analogman2/Jim-o-Lantern/cad/out/preview_body.png

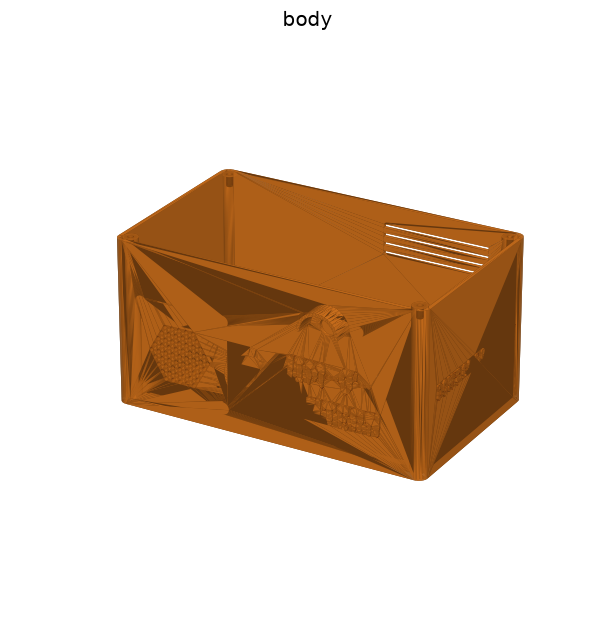
cad/out/preview_body.png
