analogman2/Jim-o-Lantern/cad/out/preview_body_inside.png

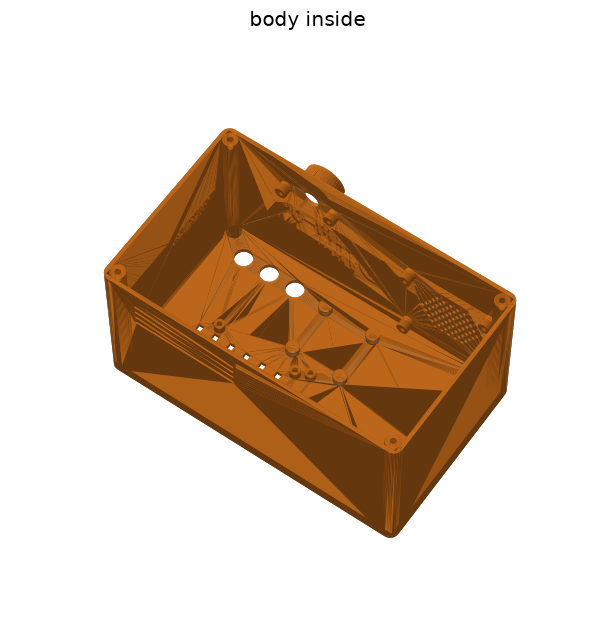
cad/out/preview_body_inside.png
