analogman2/Jim-o-Lantern/cad/out/preview_camera_mount.png

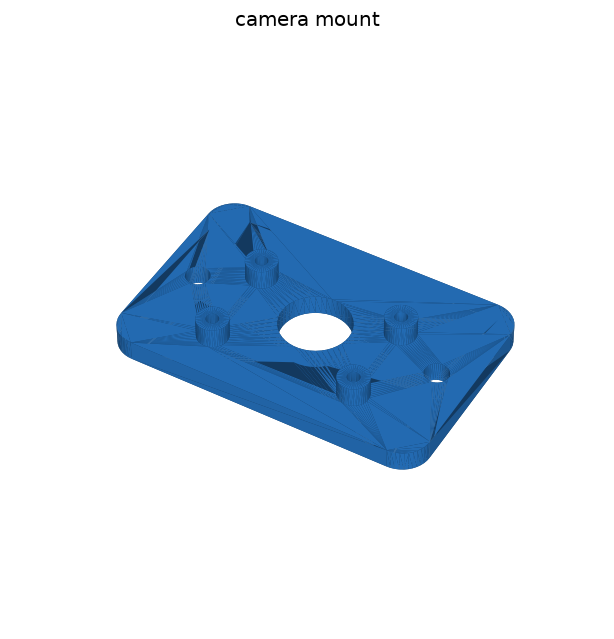
cad/out/preview_camera_mount.png
