analogman2/Jim-o-Lantern/cad/out/preview_lid.png

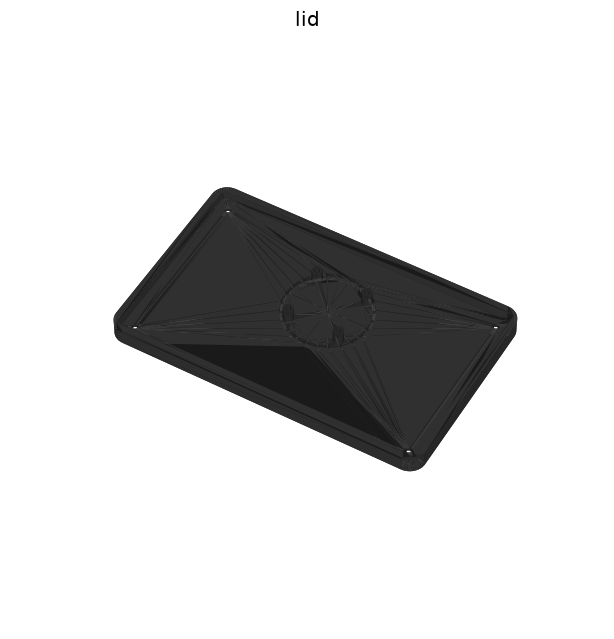
cad/out/preview_lid.png
