analogman2/Jim-o-Lantern/cad/out/preview_post_socket.png

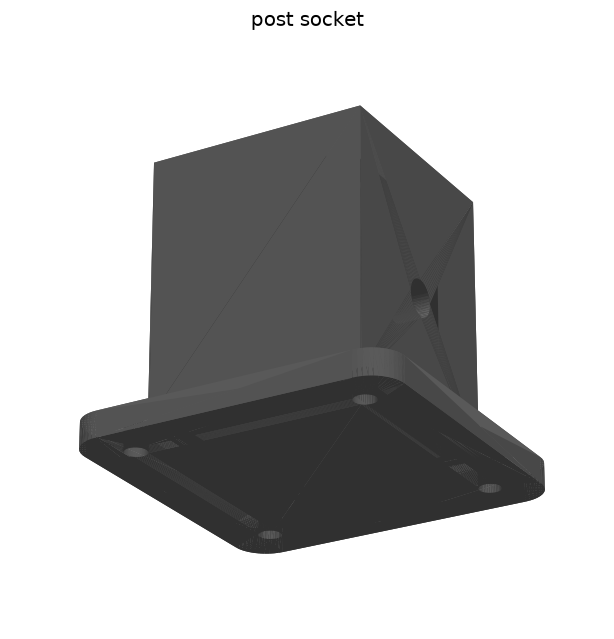
cad/out/preview_post_socket.png
