analogman2/Jim-o-Lantern/cad/out/preview_speaker_cup.png

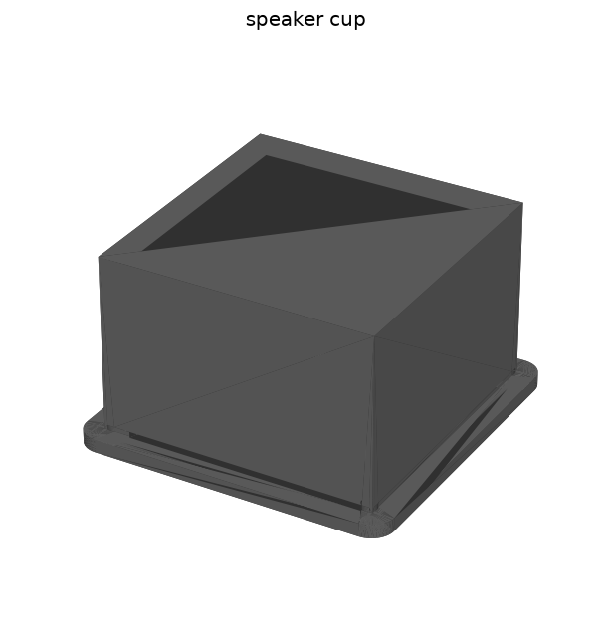
cad/out/preview_speaker_cup.png
