analogman2/Jim-o-Lantern/cad/out/lid.step

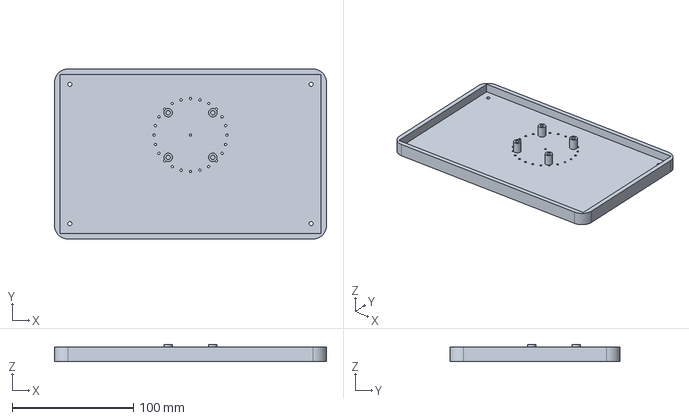
[picture p9: CAD file, 2026-10-14]
cad/out/lid.step
224.0 x 140.0 x 14.0 mm
