analogman2/Jim-o-Lantern/cad/out/camera_mount.step

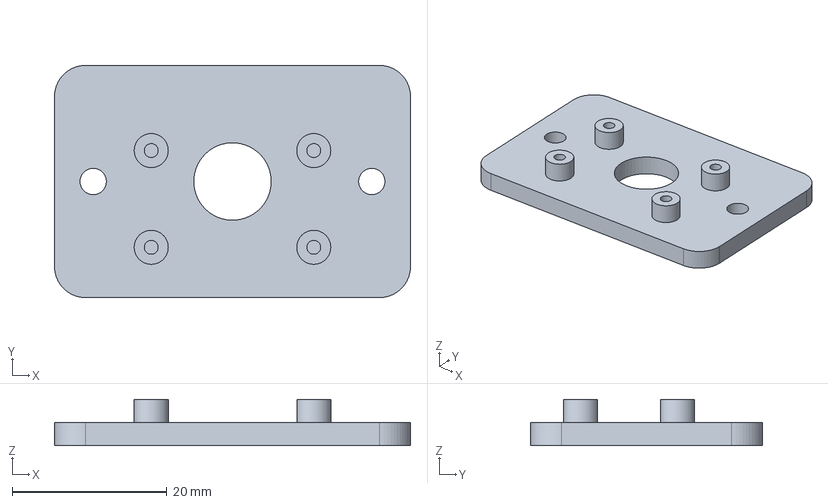
[picture p10: CAD file, 2026-10-14]
cad/out/camera_mount.step
46.0 x 30.0 x 6.00 mm
