analogman2/Jim-o-Lantern/cad/out/post_socket.step

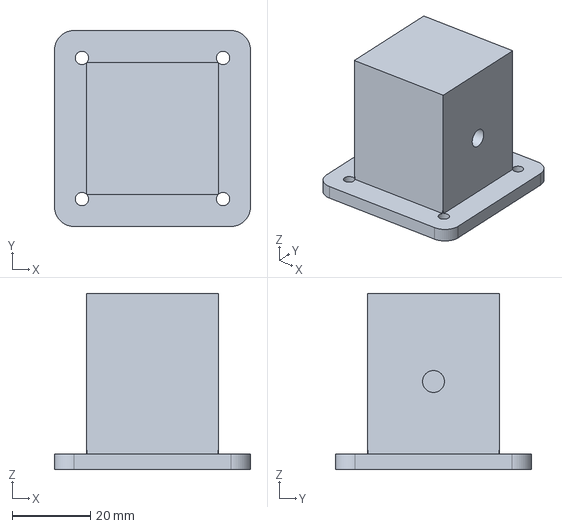
[picture p11: CAD file, 2026-10-14]
cad/out/post_socket.step
50.0 x 50.0 x 45.0 mm
