analogman2/Jim-o-Lantern/cad/out/logo.step

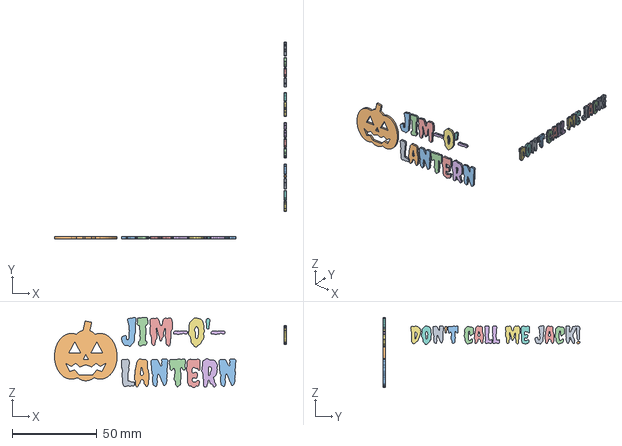
[picture p12: CAD file, 2026-10-14]
cad/out/logo.step
136.6 x 116.1 x 41.4 mm
