analogman2/Jim-o-Lantern/cad/out/speaker_cup.step

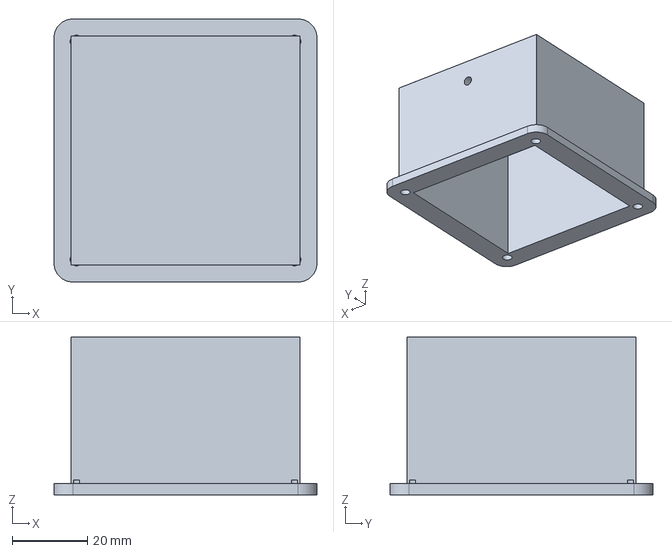
[picture p13: CAD file, 2026-10-14]
cad/out/speaker_cup.step
70.0 x 70.0 x 42.0 mm
