analogman2/Jim-o-Lantern/cad/out/body.step

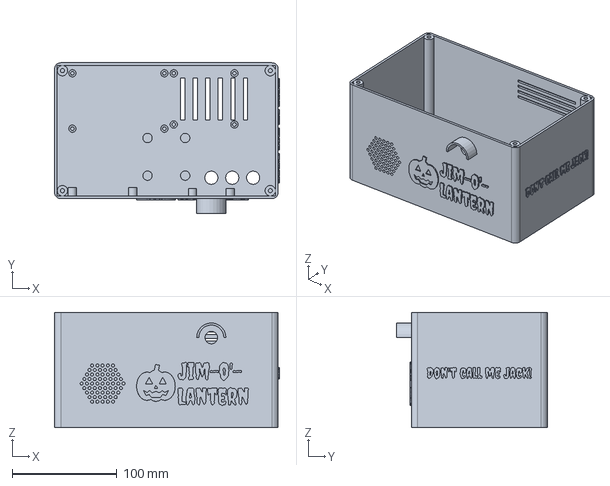
[picture p14: CAD file, 2026-10-14]
cad/out/body.step
215.2 x 144.0 x 110.0 mm
