analogman2/Jim-o-Lantern/cad/out/body_plain.step

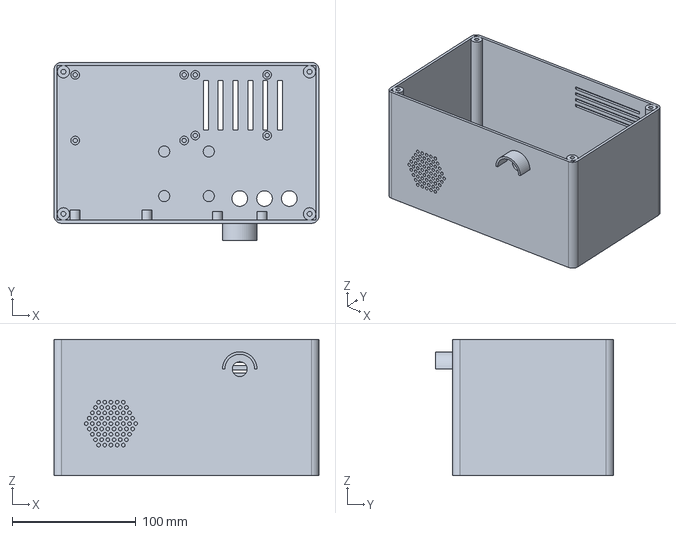
[picture p15: CAD file, 2026-10-14]
cad/out/body_plain.step
214.0 x 144.0 x 110.0 mm
