analogman2/Jim-o-Lantern/(list of files, cad)

Other CAD files:
cad/out/body.stl
cad/out/body_plain.stl
cad/out/camera_mount.stl
cad/out/lid.stl
cad/out/logo.stl
cad/out/post_socket.stl
cad/out/speaker_cup.stl
