analogman2/Jim-o-Lantern/(commit log)

2026-10-13 Jim-o-Lantern: a roasting, talking pumpkin on a WLED LED curtain
    Local pipeline: WLED mic (patched firmware) -> Whisper -> Ollama -> Qwen3-TTS,
    with a lip-synced pumpkin face, dark/eyes/scary-reveal wake-up, roast
    greetings, and a code-level gentle mode for scared kids.
2026-10-13 Add LED curtain image and hardware links to README
    The image is rendered from Jim's real face-animation code: asleep (eyes only),
    awake, and talking.
2026-10-13 Add optional RTSP camera so Jim can roast what kids are wearing
    - Camera: in-memory ffmpeg frame grabber (never writes frames to disk), auto-reconnect,
    --camera-crop / --camera-width / --no-camera. Address comes from $JIM_RTSP or
    ~/.config/jim/rtsp (written by set_camera.sh), never from the repo.
    - Wake-up roast from the current frame, generated during the reveal animation, with a
    schema-enforced "visitors visible" check and fallback to the written greetings.
    - Latest frame attached to each reply; costumes-only vision rules.
2026-10-13 Add parametric 3D-printed all-in-one box (v1) with build guide
    [body.step, body.stl, camera_mount.step, camera_mount.stl, lid.step, lid.stl, post_socket.step, post_socket.stl]
2026-10-13 Add Jim-o'-Lantern graphic to the box (raised, two-color ready)
    [body.step, body.stl, body_plain.step, body_plain.stl, camera_mount.step, lid.step, logo.step, logo.stl]
2026-10-14 Box: update for Raspberry Pi 4B (exhaust vents, power budget, 4 A fuse)
    Same footprint and mounting holes as the 3B, but warmer and hungrier: adds
    exhaust slots high on the back wall, a heatsink to the parts list, and a
    5-6 A power budget with a 4 A Pi fuse.
    [body.step, body.stl, body_plain.step, body_plain.stl, camera_mount.step, lid.step, logo.step, post_socket.step]
2026-10-14 Move this machine's addresses into jim.toml; add the jimolantern agent
    - jim.toml (not committed; template jim.example.toml) holds the WLED address,
    mic, speaker, service URLs and the camera's ip/user/path. Any command-line
    option can be set there; the command line still wins. Replaces jim.args.
    - No hard-coded IP addresses: pumpkin.py asks for `wled` in jim.toml if unset,
    and set_camera.sh takes the camera details from jim.toml.
    - Project agent (.claude/agents/jimolantern.md): architecture, rules (kid
    safety, secrets, shared GPU, speech service), test recipes, CAD notes and
    open items. Addresses are read from jim.toml, never written in the repo.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
